Lysandr/ECE3140FP----Drone-Flight-Computer/References/FRDMK64F Pinouts.PNG

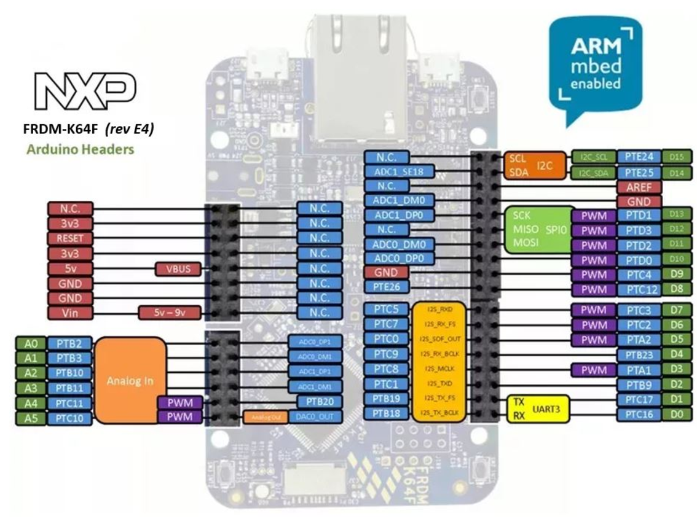
References/FRDMK64F Pinouts.PNG
