Lysandr/ECE3140FP----Drone-Flight-Computer/Cool Pictures/20170518_022048.jpg

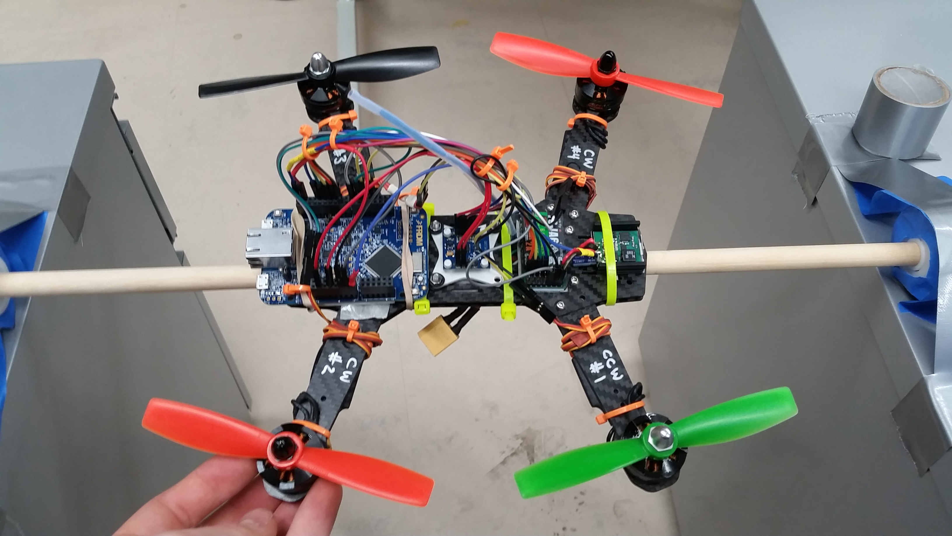
Cool Pictures/20170518_022048.jpg
