Lysandr/ECE3140FP----Drone-Flight-Computer/Cool Pictures/20170514_165914.jpg

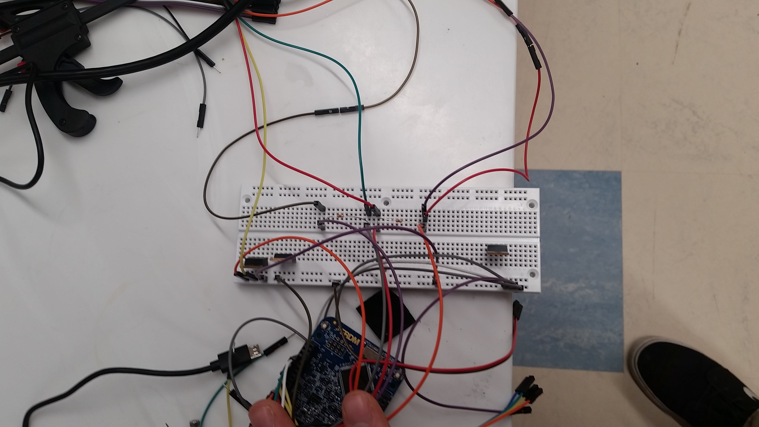
Cool Pictures/20170514_165914.jpg
