Lysandr/ECE3140FP----Drone-Flight-Computer/Cool Pictures/20170514_172808.jpg

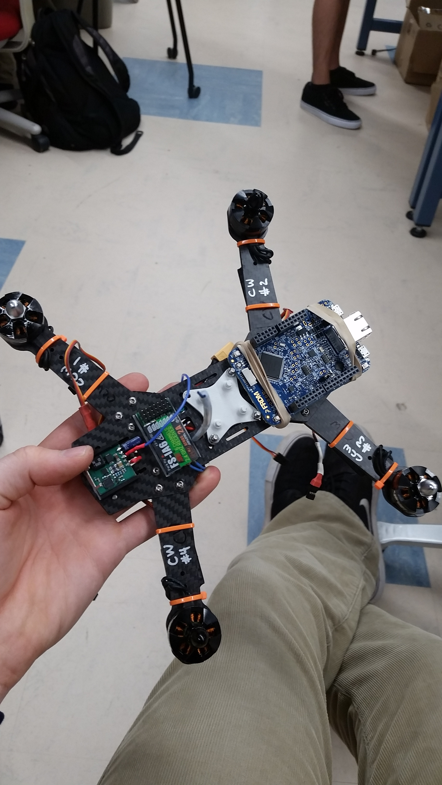
Cool Pictures/20170514_172808.jpg
