Lysandr/ECE3140FP----Drone-Flight-Computer/Cool Pictures/20170516_020817.jpg

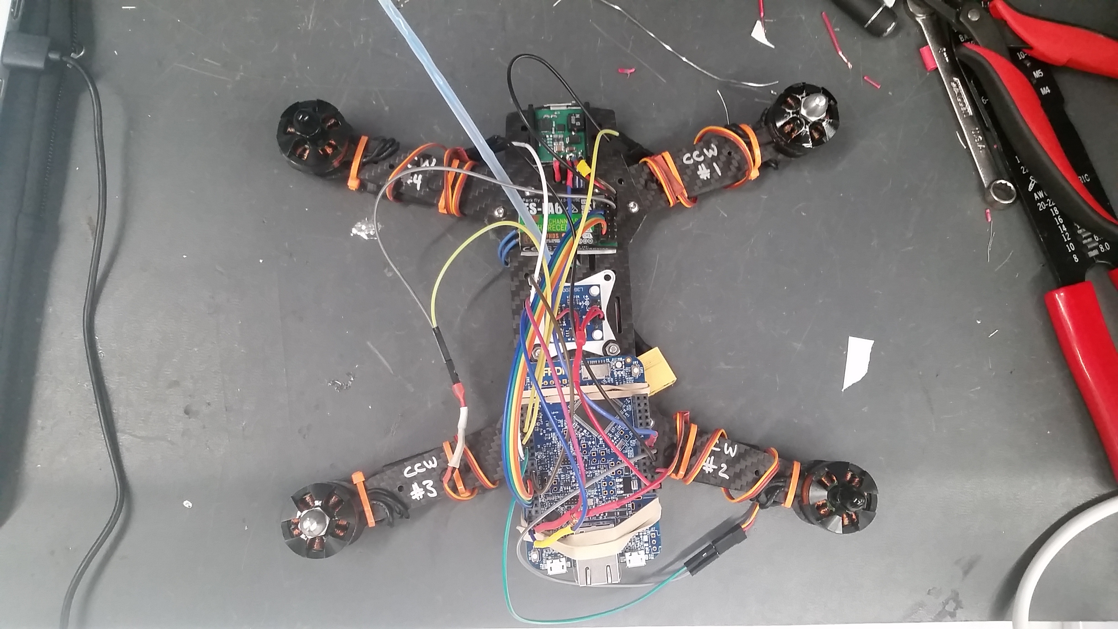
Cool Pictures/20170516_020817.jpg
