Lysandr/ECE3140FP----Drone-Flight-Computer/Cool Pictures/20170518_022053.jpg

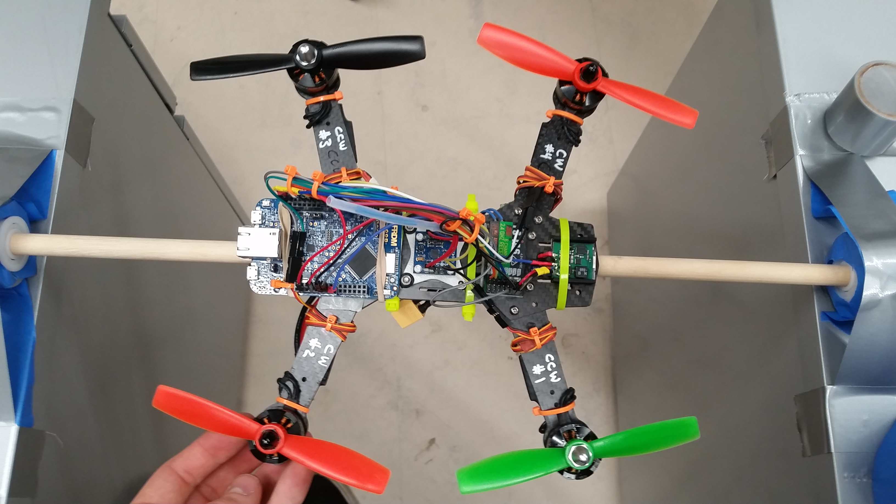
Cool Pictures/20170518_022053.jpg
