Lysandr/ECE3140FP----Drone-Flight-Computer/Cool Pictures/20170518_042248.jpg

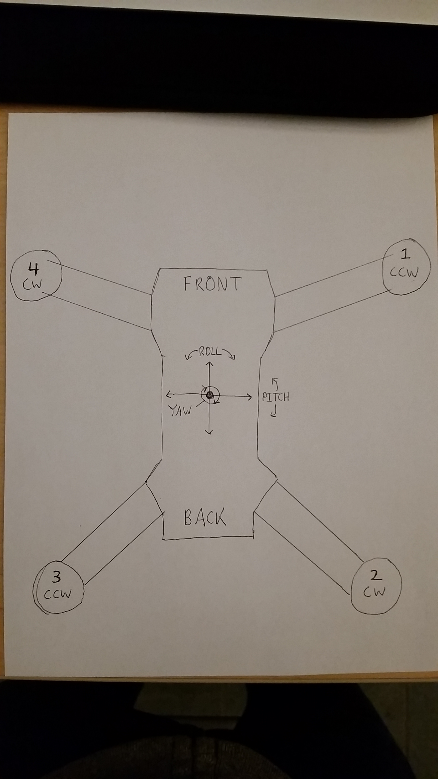
Cool Pictures/20170518_042248.jpg
