Lysandr/ECE3140FP----Drone-Flight-Computer/Cool Pictures/Screenshot_2017-05-18-02-21-38.png

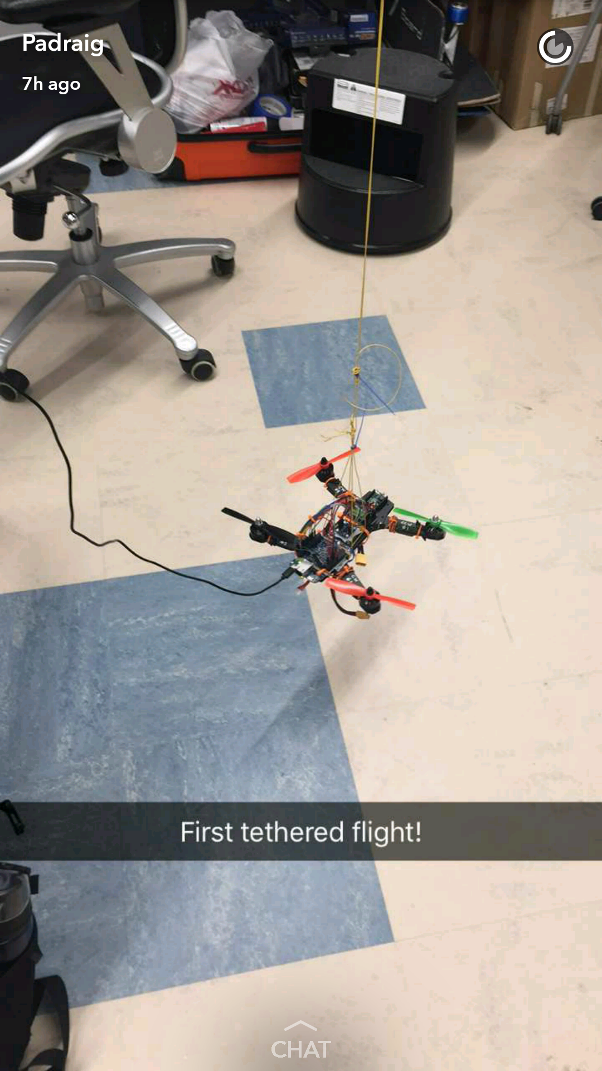
Cool Pictures/Screenshot_2017-05-18-02-21-38.png
