Lysandr/ECE3140FP----Drone-Flight-Computer/OtherCrap/board.PNG

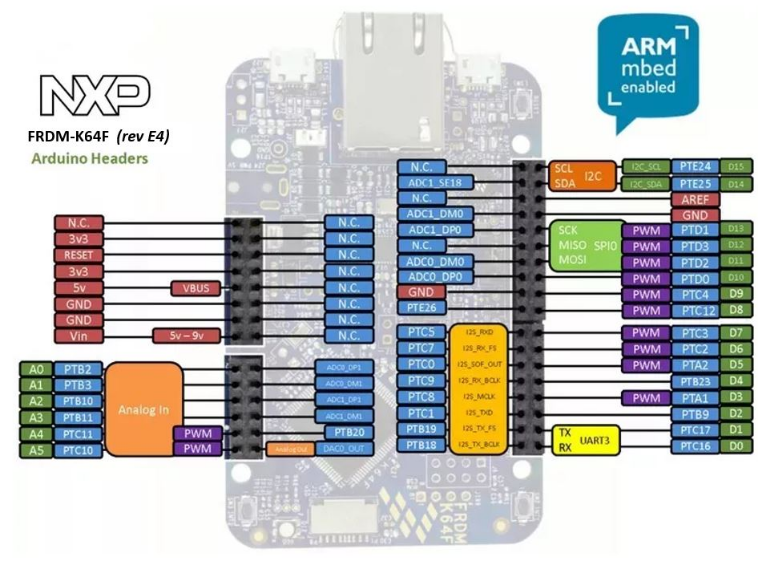
OtherCrap/board.PNG
