Lysandr/ECE3140FP----Drone-Flight-Computer/OtherCrap/main.PNG

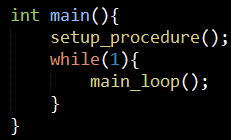
OtherCrap/main.PNG
