Lysandr/ECE3140FP----Drone-Flight-Computer/OtherCrap/Schem.PNG

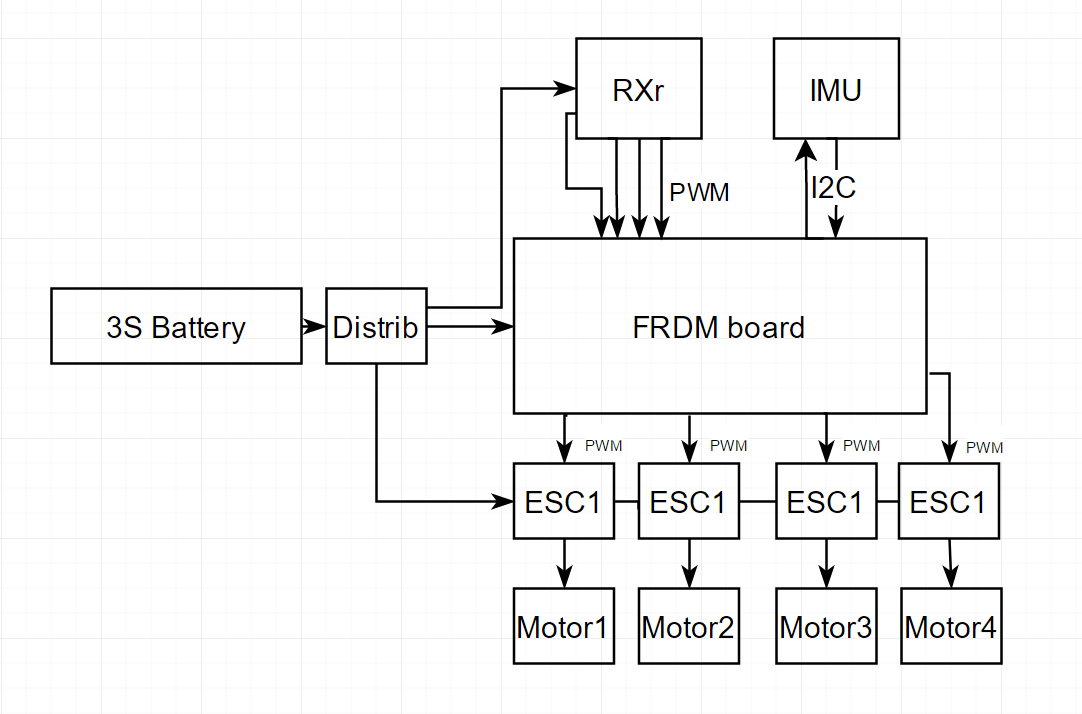
OtherCrap/Schem.PNG
