Lysandr/ECE3140FP----Drone-Flight-Computer/OtherCrap/SchematicFull.PNG

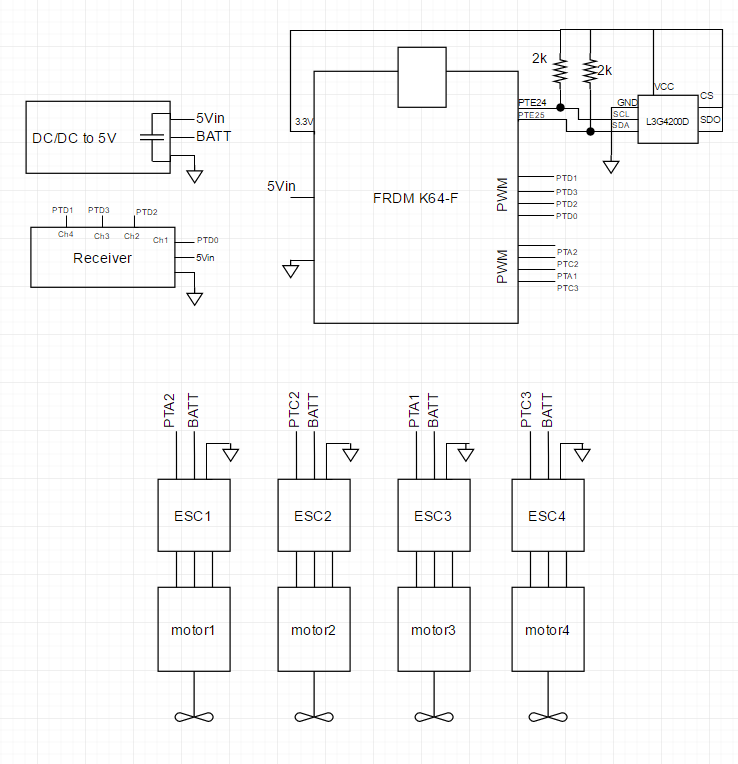
OtherCrap/SchematicFull.PNG
