Lysandr/ECE3140FP----Drone-Flight-Computer/OtherCrap/softwareblock.PNG

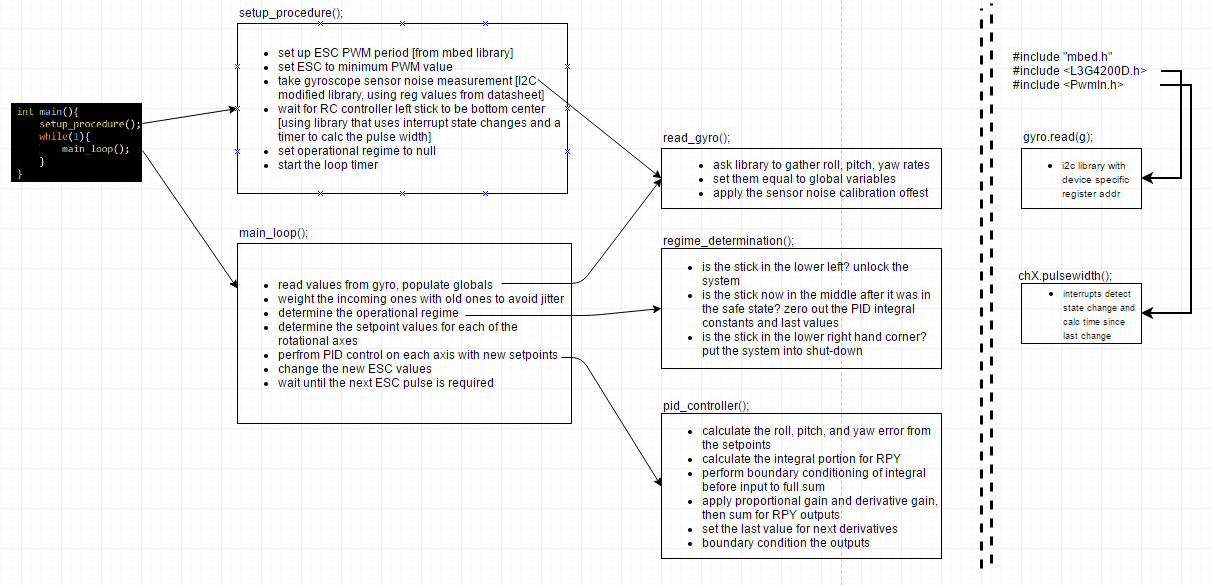
OtherCrap/softwareblock.PNG
