Lysandr/ECE3140FP----Drone-Flight-Computer/References/gryro connection.png

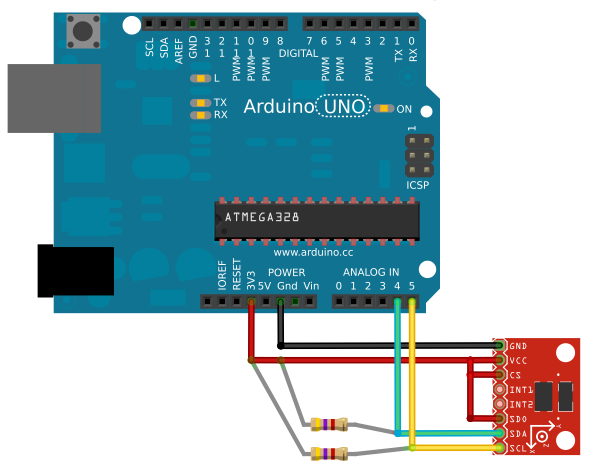
References/gryro connection.png
