Lysandr/ECE3140FP----Drone-Flight-Computer/References/TX Channels.PNG

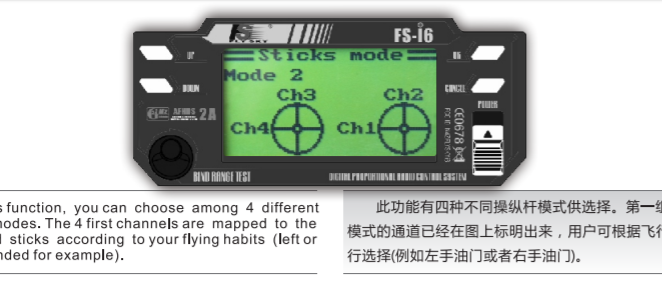
References/TX Channels.PNG
