Lysandr/ECE3140FP----Drone-Flight-Computer/(list of files, cad)

Other CAD files:
Gryo Mount.ipt
