Lysandr/ECE3140FP----Drone-Flight-Computer/main.cpp

#include "mbed-os/mbed.h"

PwmOut led(LED1);

int main() {
    // specify period first
    led.period(4.0f);      // 4 second period
    led.write(0.50f);      // 50% duty cycle, relative to period
    //led = 0.5f;          // shorthand for led.write()
    //led.pulsewidth(2);   // alternative to led.write, set duty cycle time in seconds
    while(1);
}
