Lysandr/ECE3140FP----Drone-Flight-Computer/(commit log)

2017-05-12 added i2c
2017-05-13 got gyro working
2017-05-13 added motors
2017-05-14 schematics and useful diagrams
2017-05-14 added the new PWMin libraries plus changes
2017-05-18 pictures of drone and test setup
    [Gryo Mount.ipt]
